osresearch/pdp11utils/bbb-unibus.brd

## EAGLE design bbb-unibus.brd (2014-06-13)

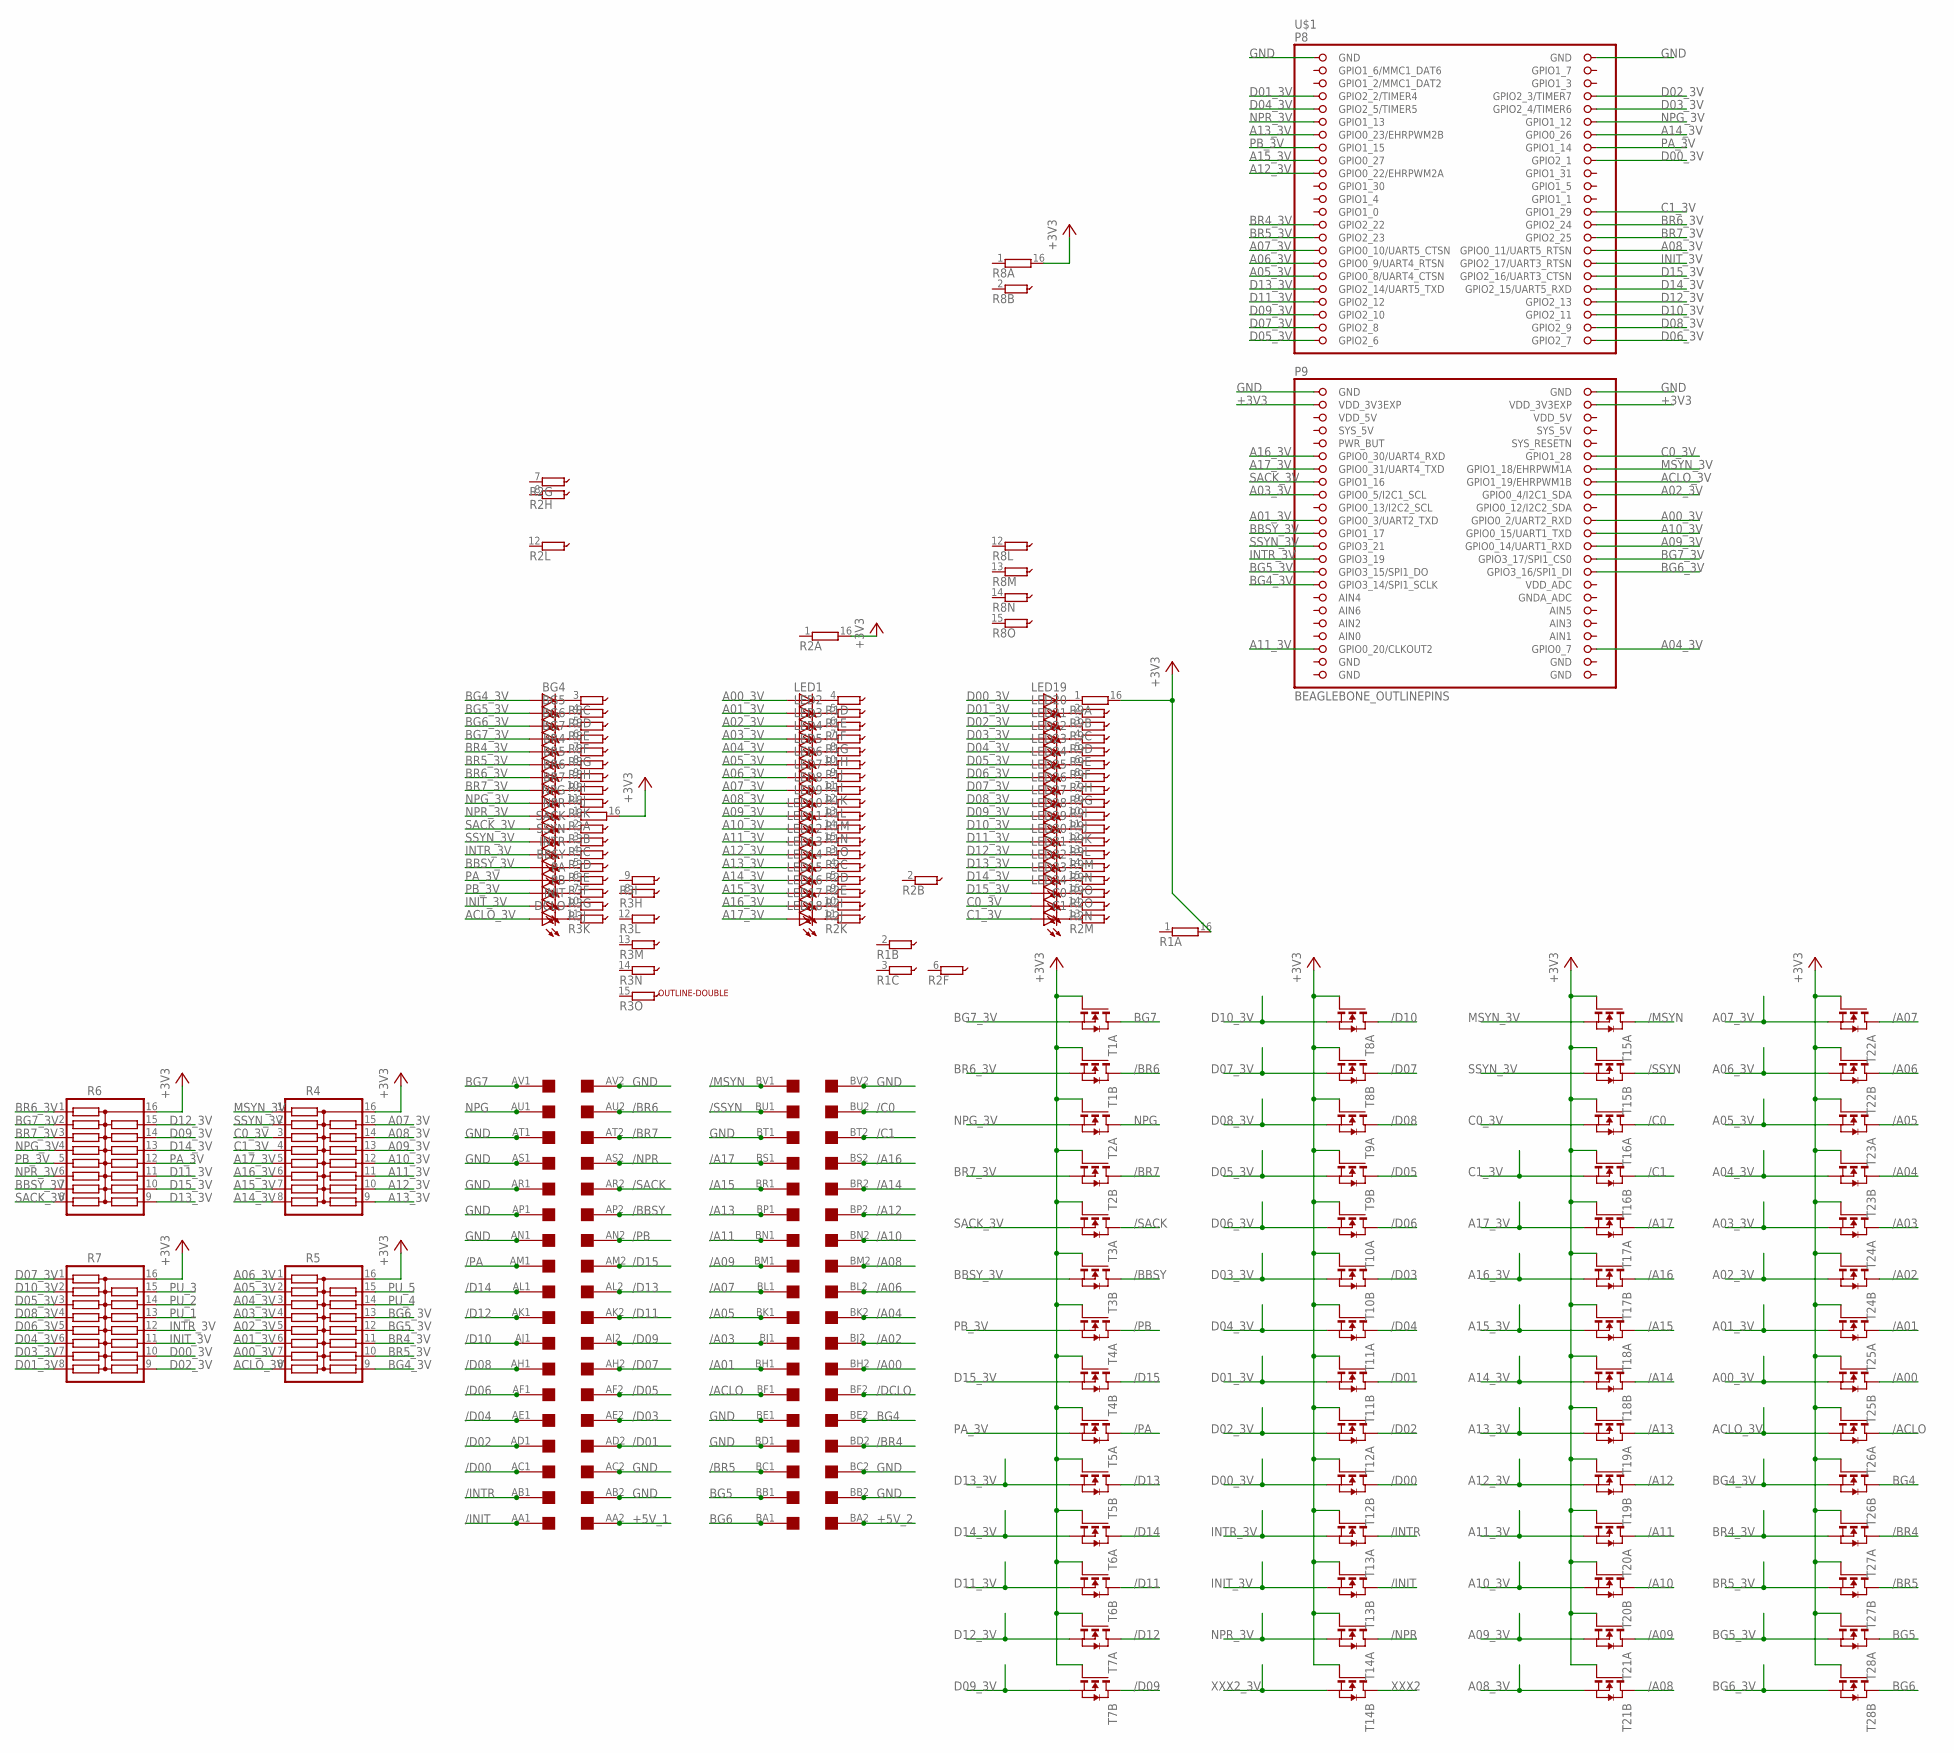
[picture p1: schematic bbb-unibus.sch]

Parts:
BBSY: LEDSML0805; SML0805
BG4, BG5, BG6, BG7: LEDSML0805; SML0805
BR4, BR5, BR6, BR7: LEDSML0805; SML0805
C0, C1: LEDSML0805; SML0805
DCLO: LEDSML0805; SML0805
INIT: LEDSML0805; SML0805
INTR: LEDSML0805; SML0805
LED1, LED2, LED3, LED4, LED5, LED6, LED7, LED8, LED9, LED10, LED11, LED12, LED13, LED14, LED15, LED16, LED17, LED18, LED19, LED20, LED21, LED22, LED23, LED24, LED25, LED26, LED27, LED28, LED29, LED30, LED31, LED32, LED33, LED34: LEDSML0805; SML0805
NPG: LEDSML0805; SML0805
NPR: LEDSML0805; SML0805
PA: LEDSML0805; SML0805
PB: LEDSML0805; SML0805
R1, R2, R3, R8, R9: 2QSP16-15E; 2QSP16
R4, R5, R6, R7: 2QSP16-15; 2QSP16
SACK: LEDSML0805; SML0805
SSYN: LEDSML0805; SML0805
T1, T2, T3, T4, T5, T6, T7, T8, T9, T10, T11, T12, T13, T14, T15, T16, T17, T18, T19, T20, T21, T22, T23, T24, T25, T26, T27, T28: NMOS2-BSS138DW; SOT363
U$1: BEAGLEBONE_OUTLINEPINS; BEAGLEBONE_PINS
U$2: OUTLINE-DOUBLE; DOUBLE
U$3: DOUBLE; EDGE-CON4

Connections:
+3V3: R1.16 (2), R2.16 (2), R3.16 (2), R4.16, R5.16, R6.16, R7.16, R8.16 (2), R9.16 (2), T1.2 (G), T1.5 (G), T2.2 (G), T2.5 (G), T3.2 (G), T3.5 (G), T4.2 (G), T4.5 (G), T5.2 (G), T5.5 (G), T6.2 (G), T6.5 (G), T7.2 (G), T7.5 (G), T8.2 (G), T8.5 (G), T9.2 (G), T9.5 (G), T10.2 (G), T10.5 (G), T11.2 (G), T11.5 (G), T12.2 (G), T12.5 (G), T13.2 (G), T13.5 (G), T14.2 (G), T14.5 (G), T15.2 (G), T15.5 (G), T16.2 (G), T16.5 (G), T17.2 (G), T17.5 (G), T18.2 (G), T18.5 (G), T19.2 (G), T19.5 (G), T20.2 (G), T20.5 (G), T21.2 (G), T21.5 (G), T22.2 (G), T22.5 (G), T23.2 (G), T23.5 (G), T24.2 (G), T24.5 (G), T25.2 (G), T25.5 (G), T26.2 (G), T26.5 (G), T27.2 (G), T27.5 (G), T28.2 (G), T28.5 (G), U$1.49 (VDD_3V3EXP), U$1.50 (VDD_3V3EXP)
+5V_1: U$3.AA2
+5V_2: U$3.BA2
/A00: T25.6 (D), U$3.BH2
/A01: T25.3 (D), U$3.BH1
/A02: T24.6 (D), U$3.BJ2
/A03: T24.3 (D), U$3.BJ1
/A04: T23.6 (D), U$3.BK2
/A05: T23.3 (D), U$3.BK1
/A06: T22.6 (D), U$3.BL2
/A07: T22.3 (D), U$3.BL1
/A08: T21.6 (D), U$3.BM2
/A09: T21.3 (D), U$3.BM1
/A10: T20.6 (D), U$3.BN2
/A11: T20.3 (D), U$3.BN1
/A12: T19.6 (D), U$3.BP2
/A13: T19.3 (D), U$3.BP1
/A14: T18.6 (D), U$3.BR2
/A15: T18.3 (D), U$3.BR1
/A16: T17.6 (D), U$3.BS2
/A17: T17.3 (D), U$3.BS1
/ACLO: T26.3 (D), U$3.BF1
/BBSY: T3.6 (D), U$3.AP2
/BR4: T27.3 (D), U$3.BD2
/BR5: T27.6 (D), U$3.BC1
/BR6: T1.6 (D), U$3.AU2
/BR7: T2.6 (D), U$3.AT2
/C0: T16.3 (D), U$3.BU2
/C1: T16.6 (D), U$3.BT2
/D00: T12.6 (D), U$3.AC1
/D01: T11.6 (D), U$3.AD2
/D02: T12.3 (D), U$3.AD1
/D03: T10.6 (D), U$3.AE2
/D04: T11.3 (D), U$3.AE1
/D05: T9.6 (D), U$3.AF2
/D06: T10.3 (D), U$3.AF1
/D07: T8.6 (D), U$3.AH2
/D08: T9.3 (D), U$3.AH1
/D09: T7.6 (D), U$3.AJ2
/D10: T8.3 (D), U$3.AJ1
/D11: T6.6 (D), U$3.AK2
/D12: T7.3 (D), U$3.AK1
/D13: T5.6 (D), U$3.AL2
/D14: T6.3 (D), U$3.AL1
/D15: T4.6 (D), U$3.AM2
/DCLO: U$3.BF2
/INIT: T13.6 (D), U$3.AA1
/INTR: T13.3 (D), U$3.AB1
/MSYN: T15.3 (D), U$3.BV1
/NPR: T14.3 (D), U$3.AS2
/PA: T5.3 (D), U$3.AM1
/PB: T4.3 (D), U$3.AN2
/SACK: T3.3 (D), U$3.AR2
/SSYN: T15.6 (D), U$3.BU1
A00_3V: LED1.A, R5.7, T25.4 (S), U$1.68 (GPIO0_2/UART2_RXD)
A01_3V: LED2.A, R5.6, T25.1 (S), U$1.67 (GPIO0_3/UART2_TXD)
A02_3V: LED3.A, R5.5, T24.4 (S), U$1.64 (GPIO0_4/I2C1_SDA)
A03_3V: LED4.A, R5.4, T24.1 (S), U$1.63 (GPIO0_5/I2C1_SCL)
A04_3V: LED5.A, R5.3, T23.4 (S), U$1.88 (GPIO0_7)
A05_3V: LED6.A, R5.2, T23.1 (S), U$1.35 (GPIO0_8/UART4_CTSN)
A06_3V: LED7.A, R5.1, T22.4 (S), U$1.33 (GPIO0_9/UART4_RTSN)
A07_3V: LED8.A, R4.15, T22.1 (S), U$1.31 (GPIO0_10/UART5_CTSN)
A08_3V: LED9.A, R4.14, T21.4 (S), U$1.32 (GPIO0_11/UART5_RTSN)
A09_3V: LED10.A, R4.13, T21.1 (S), U$1.72 (GPIO0_14/UART1_RXD)
A10_3V: LED11.A, R4.12, T20.4 (S), U$1.70 (GPIO0_15/UART1_TXD)
A11_3V: LED12.A, R4.11, T20.1 (S), U$1.87 (GPIO0_20/CLKOUT2)
A12_3V: LED13.A, R4.10, T19.4 (S), U$1.19 (GPIO0_22/EHRPWM2A)
A13_3V: LED14.A, R4.9, T19.1 (S), U$1.13 (GPIO0_23/EHRPWM2B)
A14_3V: LED15.A, R4.8, T18.4 (S), U$1.14 (GPIO0_26)
A15_3V: LED16.A, R4.7, T18.1 (S), U$1.17 (GPIO0_27)
A16_3V: LED17.A, R4.6, T17.4 (S), U$1.57 (GPIO0_30/UART4_RXD)
A17_3V: LED18.A, R4.5, T17.1 (S), U$1.59 (GPIO0_31/UART4_TXD)
ACLO_3V: DCLO.A, R5.8, T26.1 (S), U$1.62 (GPIO1_19/EHRPWM1B)
AIN0: U$1.85 (AIN0)
BBSY_3V: BBSY.A, R6.7, T3.4 (S), U$1.69 (GPIO1_17)
BG4: T26.6 (D), U$3.BE2
BG4_3V: BG4.A, R5.9, T26.4 (S), U$1.77 (GPIO3_14/SPI1_SCLK)
BG5: T28.3 (D), U$3.BB1
BG5_3V: BG5.A, R5.12, T28.1 (S), U$1.75 (GPIO3_15/SPI1_DO)
BG6: T28.6 (D), U$3.BA1
BG6_3V: BG6.A, R5.13, T28.4 (S), U$1.76 (GPIO3_16/SPI1_DI)
BG7: T1.3 (D), U$3.AV1
BG7_3V: BG7.A, R6.2, T1.1 (S), U$1.74 (GPIO3_17/SPI1_CS0)
BR4_3V: BR4.A, R5.11, T27.1 (S), U$1.27 (GPIO2_22)
BR5_3V: BR5.A, R5.10, T27.4 (S), U$1.29 (GPIO2_23)
BR6_3V: BR6.A, R6.1, T1.4 (S), U$1.28 (GPIO2_24)
BR7_3V: BR7.A, R6.3, T2.4 (S), U$1.30 (GPIO2_25)
C0_3V: C0.A, R4.3, T16.1 (S), U$1.58 (GPIO1_28)
C1_3V: C1.A, R4.4, T16.4 (S), U$1.26 (GPIO1_29)
D00_3V: LED19.A, R7.10, T12.4 (S), U$1.18 (GPIO2_1)
D01_3V: LED20.A, R7.8, T11.4 (S), U$1.7 (GPIO2_2/TIMER4)
D02_3V: LED21.A, R7.9, T12.1 (S), U$1.8 (GPIO2_3/TIMER7)
D03_3V: LED22.A, R7.7, T10.4 (S), U$1.10 (GPIO2_4/TIMER6)
D04_3V: LED23.A, R7.6, T11.1 (S), U$1.9 (GPIO2_5/TIMER5)
D05_3V: LED24.A, R7.3, T9.4 (S), U$1.45 (GPIO2_6)
D06_3V: LED25.A, R7.5, T10.1 (S), U$1.46 (GPIO2_7)
D07_3V: LED26.A, R7.1, T8.4 (S), U$1.43 (GPIO2_8)
D08_3V: LED27.A, R7.4, T9.1 (S), U$1.44 (GPIO2_9)
D09_3V: LED28.A, R6.14, T7.4 (S), U$1.41 (GPIO2_10)
D10_3V: LED29.A, R7.2, T8.1 (S), U$1.42 (GPIO2_11)
D11_3V: LED30.A, R6.11, T6.4 (S), U$1.39 (GPIO2_12)
D12_3V: LED31.A, R6.15, T7.1 (S), U$1.40 (GPIO2_13)
D13_3V: LED32.A, R6.9, T5.4 (S), U$1.37 (GPIO2_14/UART5_TXD)
D14_3V: LED33.A, R6.13, T6.1 (S), U$1.38 (GPIO2_15/UART5_RXD)
D15_3V: LED34.A, R6.10, T4.4 (S), U$1.36 (GPIO2_16/UART3_CTSN)
GND: U$1.1 (GND), U$1.2 (GND), U$1.47 (GND), U$1.48 (GND), U$3.AB2, U$3.AC2, U$3.AN1, U$3.AP1, U$3.AR1, U$3.AS1, U$3.AT1, U$3.AV2, U$3.BB2, U$3.BC2, U$3.BD1, U$3.BE1, U$3.BT1, U$3.BV2
INIT_3V: INIT.A, R7.11, T13.4 (S), U$1.34 (GPIO2_17/UART3_RTSN)
INTR_3V: INTR.A, R7.12, T13.1 (S), U$1.73 (GPIO3_19)
MSYN_3V: R4.1, T15.1 (S), U$1.60 (GPIO1_18/EHRPWM1A)
unnamed: LED34.C, R2.15 (1)
unnamed: C0.C, R2.14 (1)
unnamed: C1.C, R2.13 (1)
unnamed: LED16.C, R2.9 (1)
unnamed: LED1.C, R1.4 (1)
unnamed: LED2.C, R1.5 (1)
unnamed: LED3.C, R1.6 (1)
unnamed: LED4.C, R1.7 (1)
unnamed: LED5.C, R1.8 (1)
unnamed: LED6.C, R1.10 (1)
unnamed: LED7.C, R1.9 (1)
unnamed: LED8.C, R1.11 (1)
unnamed: LED9.C, R1.12 (1)
unnamed: LED10.C, R1.13 (1)
unnamed: LED11.C, R1.14 (1)
unnamed: LED12.C, R1.15 (1)
unnamed: LED13.C, R2.3 (1)
unnamed: LED17.C, R2.10 (1)
unnamed: LED18.C, R2.11 (1)
unnamed: LED14.C, R2.4 (1)
unnamed: LED15.C, R2.5 (1)
unnamed: BR5.C, R8.8 (1)
unnamed: BR4.C, R8.7 (1)
unnamed: BG7.C, R8.6 (1)
unnamed: BG6.C, R8.5 (1)
unnamed: BG5.C, R8.4 (1)
unnamed: BG4.C, R8.3 (1)
unnamed: BR6.C, R8.9 (1)
unnamed: BR7.C, R8.10 (1)
unnamed: NPG.C, R8.11 (1)
unnamed: LED26.C, R9.7 (1)
unnamed: NPR.C, R3.1
unnamed: LED25.C, R9.8 (1)
unnamed: R3.2 (1), SACK.C
unnamed: R3.3 (1), SSYN.C
unnamed: INTR.C, R3.4 (1)
unnamed: LED19.C, R9.1
unnamed: LED20.C, R9.2 (1)
unnamed: LED21.C, R9.3 (1)
unnamed: LED22.C, R9.4 (1)
unnamed: LED23.C, R9.5 (1)
unnamed: LED24.C, R9.6 (1)
unnamed: LED27.C, R9.9 (1)
unnamed: LED28.C, R9.10 (1)
unnamed: LED29.C, R9.11 (1)
unnamed: LED30.C, R9.12 (1)
unnamed: LED31.C, R9.13 (1)
unnamed: LED32.C, R9.14 (1)
unnamed: LED33.C, R9.15 (1)
unnamed: BBSY.C, R3.5 (1)
unnamed: PA.C, R3.6 (1)
unnamed: PB.C, R3.7 (1)
unnamed: INIT.C, R3.10 (1)
unnamed: DCLO.C, R3.11 (1)
NPG: T2.3 (D), U$3.AU1
NPG_3V: NPG.A, R6.4, T2.1 (S), U$1.12 (GPIO1_12)
NPR_3V: NPR.A, R6.6, T14.1 (S), U$1.11 (GPIO1_13)
PA_3V: PA.A, R6.12, T5.1 (S), U$1.16 (GPIO1_14)
PB_3V: PB.A, R6.5, T4.1 (S), U$1.15 (GPIO1_15)
PU_1: R7.13
PU_2: R7.14
PU_3: R7.15
PU_4: R5.14
PU_5: R5.15
SACK_3V: R6.8, SACK.A, T3.1 (S), U$1.61 (GPIO1_16)
SSYN_3V: R4.2, SSYN.A, T15.4 (S), U$1.71 (GPIO3_21)
SYS_5V: U$1.53 (SYS_5V)
UNUSED_GND0: U$1.89 (GND)
UNUSED_GND1: U$1.91 (GND)
UNUSED_GND2: U$1.90 (GND)
UNUSED_GND3: U$1.92 (GND)
VDD_5V: U$1.51 (VDD_5V), U$1.52 (VDD_5V)
XXX2: T14.6 (D)
XXX2_3V: T14.4 (S)

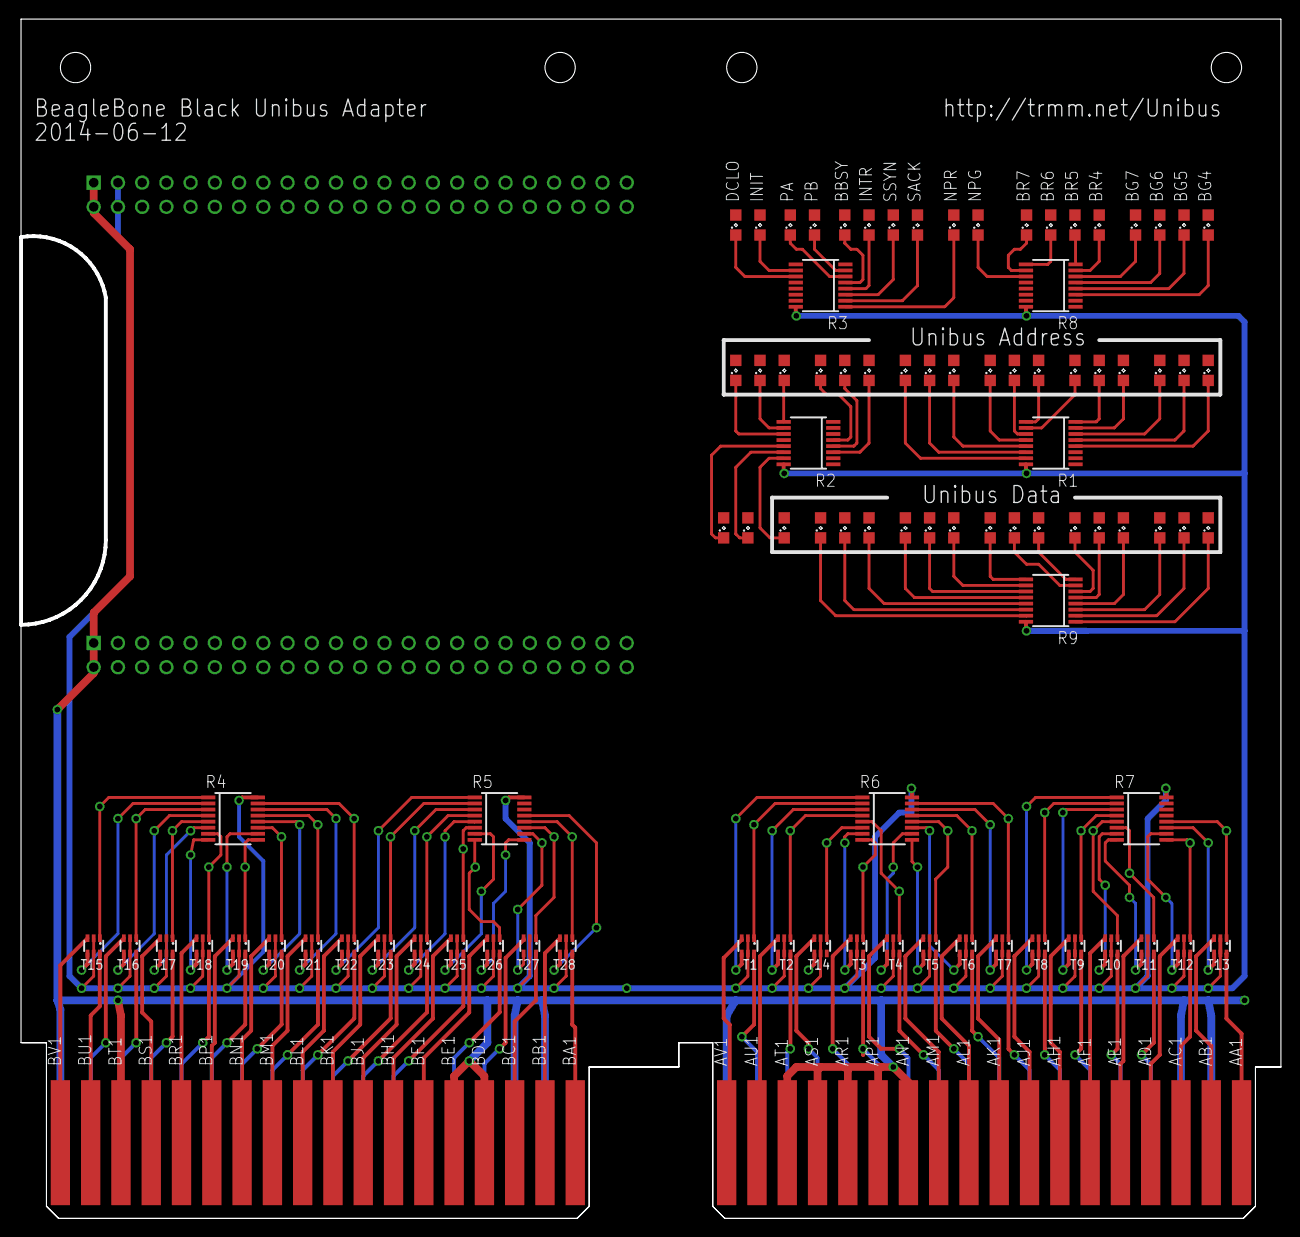
[picture p2: board bbb-unibus.brd from above]

Board: 2 copper layers, 132.1 x 125.7 mm, 94 parts (1 on the bottom side), 167 nets.
