osresearch/pdp11utils/(commit log)

2014-06-13 BeagleBone Black Unibus adapter (unrouted)
    [bbb-unibus.brd, bbb-unibus.sch]
2014-06-13 vector font
    [bbb-unibus.brd]
2014-06-13 import of digital logo
    [bbb-unibus.brd]
2014-06-13 use 200dpi import rather than 1000 for logo
    [bbb-unibus.brd]
2014-06-28 lots of gpio fixes; need a makefile
    [bitshuffle.h, gpio.c, gpio.h, unibus-monitor.c]
2014-06-29 fix offset of pins
    [gpio.c, gpio.h]
2014-06-29 fix addres bit ranges
    [unibus-monitor.c]
2014-06-29 switch back to inline macros
2014-06-29 fix u->init bit read
    [unibus.c]
2014-06-29 enable debugging and check for map failure
    [unibus.c]
